Newphant/newphant-arm/assets/usd/Action_Graph.png

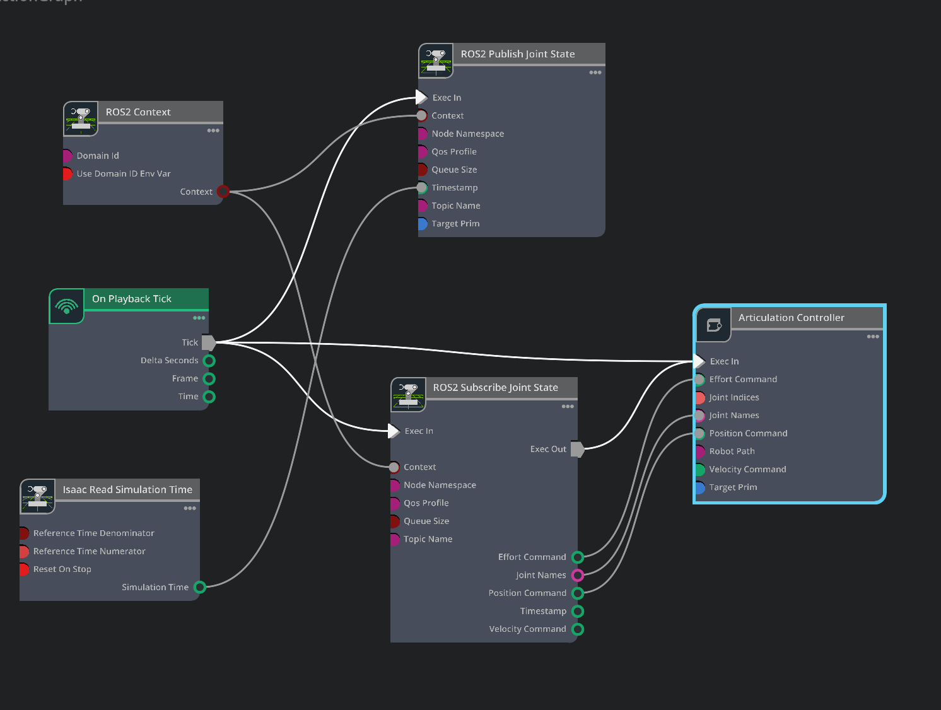
assets/usd/Action_Graph.png
