Newphant/newphant-arm/assets/urdf/main_arm/asset/rocker_right.stl

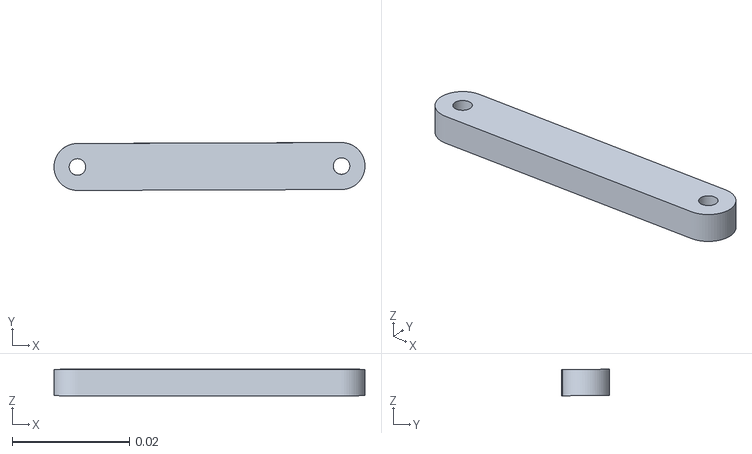
[picture p2: CAD file, 2026-11-11]
assets/urdf/main_arm/asset/rocker_right.stl
0.053 x 0.00817 x 0.00452
