Newphant/newphant-arm/cad/Gripper/adapter_head.step

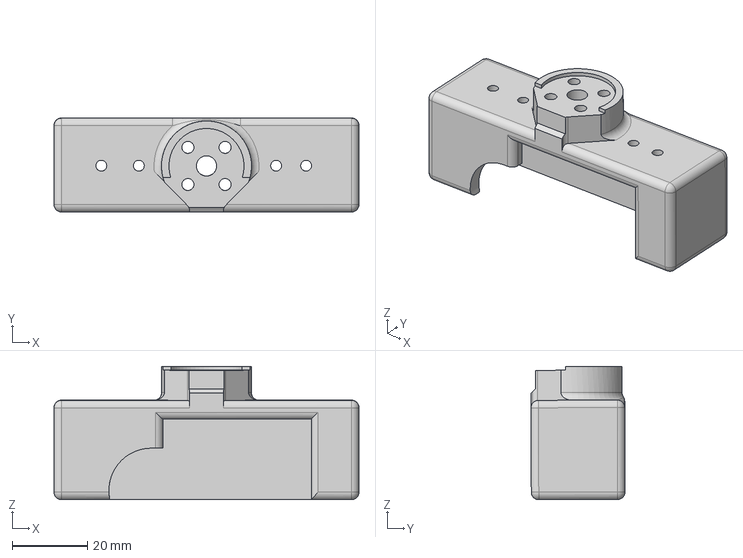
[picture p3: CAD file, 2026-11-11]
cad/Gripper/adapter_head.step
81.3 x 25.1 x 35.6 mm
