Newphant/newphant-arm/cad/ST3215_servo.step

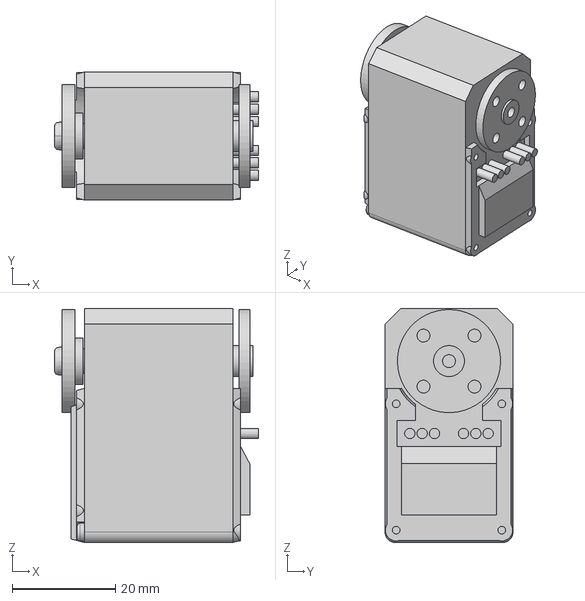
[picture p4: CAD file, 2026-11-11]
cad/ST3215_servo.step
39.6 x 24.8 x 45.4 mm
