Newphant/newphant-arm/assets/urdf/main_arm/asset/servo_ShA_should.stl

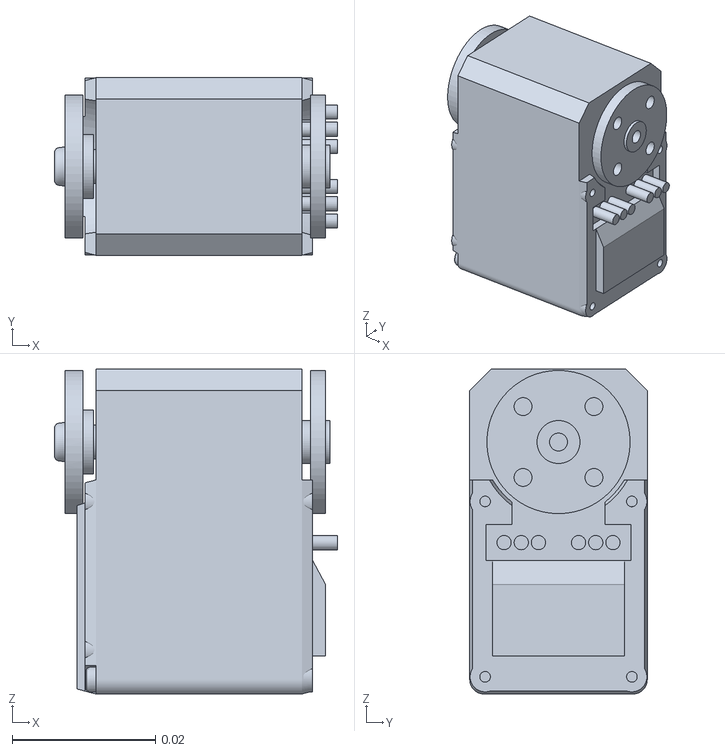
[picture p5: CAD file, 2026-11-11]
assets/urdf/main_arm/asset/servo_ShA_should.stl
0.0396 x 0.0248 x 0.0454
