Newphant/newphant-arm/cad/elbow_arm.step

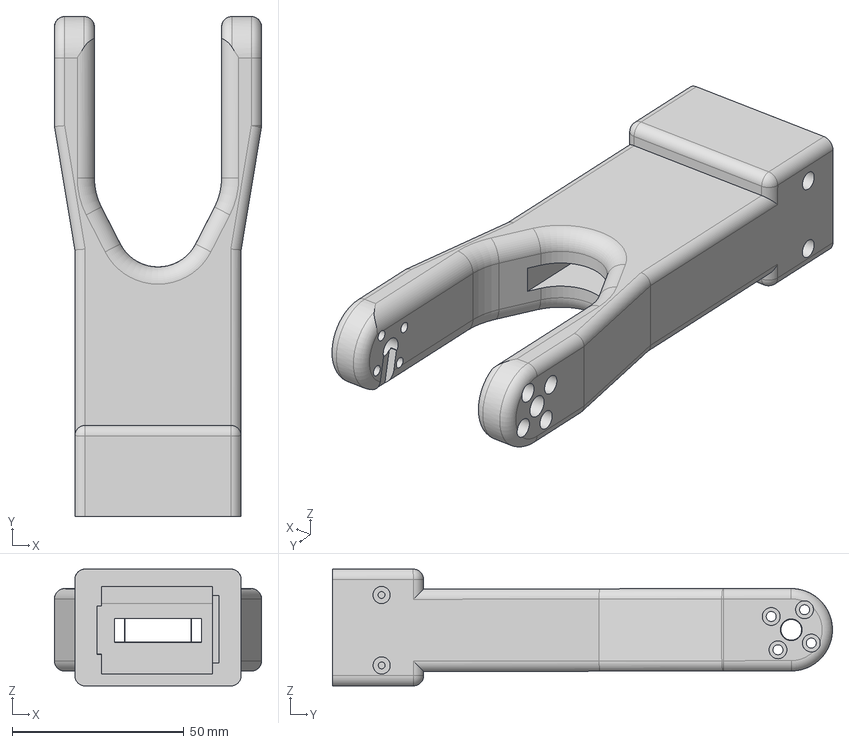
[picture p6: CAD file, 2026-11-11]
cad/elbow_arm.step
60.3 x 145.5 x 34.0 mm
