Newphant/newphant-arm/cad/Gripper/rocker_left.step

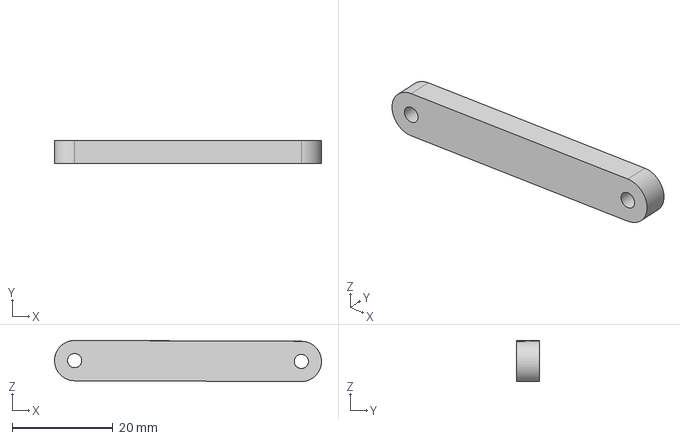
[picture p7: CAD file, 2026-11-11]
cad/Gripper/rocker_left.step
53.0 x 4.52 x 8.17 mm
