Newphant/newphant-arm/assets/urdf/main_arm/asset/coupler_right.stl

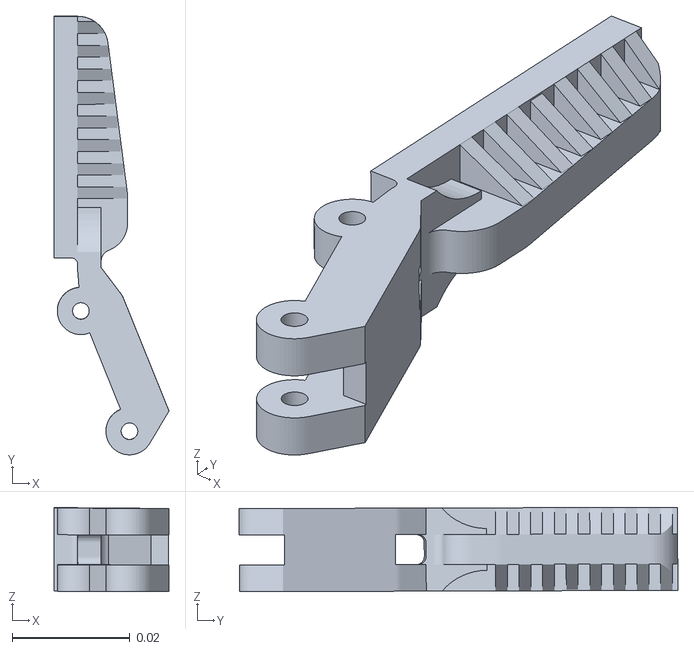
[picture p8: CAD file, 2026-11-11]
assets/urdf/main_arm/asset/coupler_right.stl
0.0195 x 0.0744 x 0.0143
