Newphant/newphant-arm/cad/ball_bearing.step

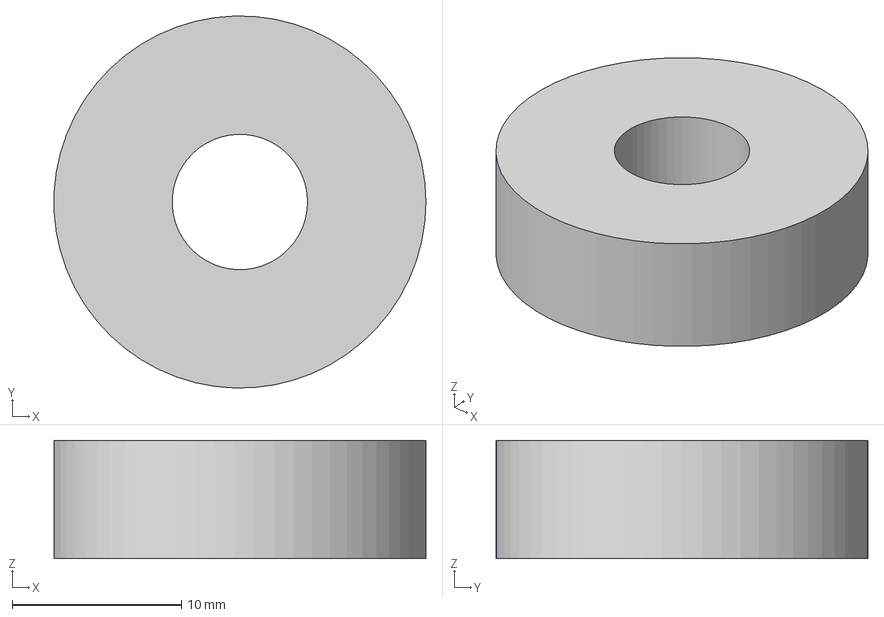
[picture p9: CAD file, 2026-11-11]
cad/ball_bearing.step
22.0 x 22.0 x 7.00 mm
