Newphant/newphant-arm/cad/Gripper/crank_right.step

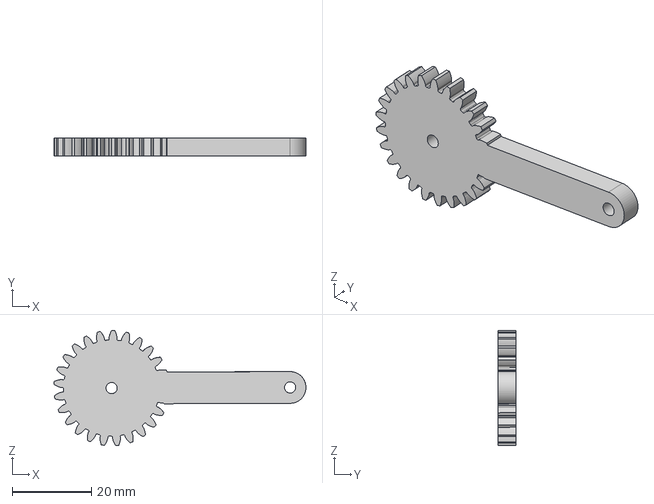
[picture p10: CAD file, 2026-11-11]
cad/Gripper/crank_right.step
63.5 x 4.59 x 29.1 mm
