Newphant/newphant-arm/assets/urdf/main_arm/asset/base_plate.stl

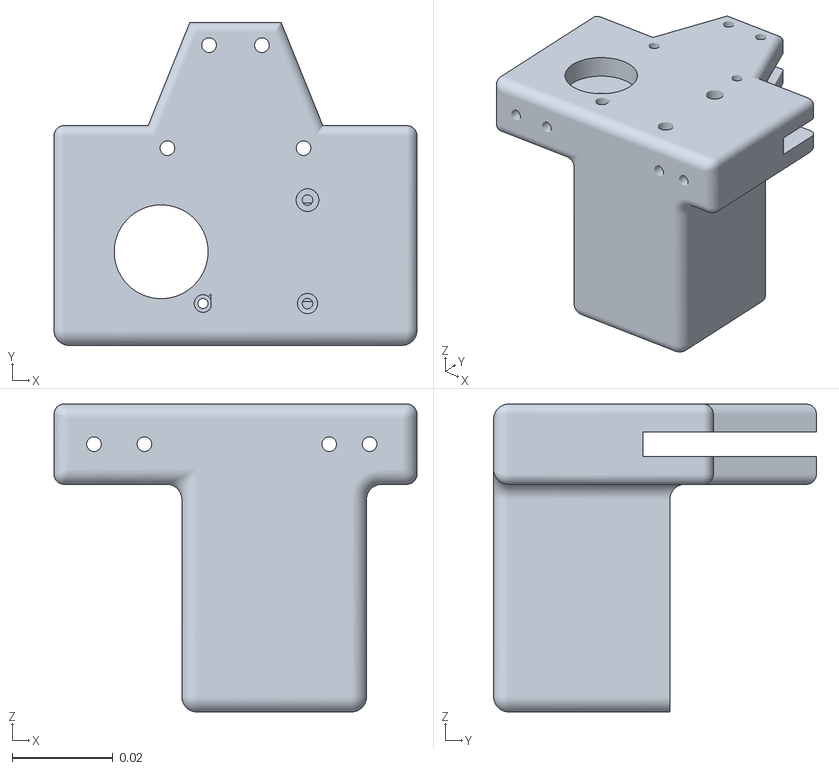
[picture p11: CAD file, 2026-11-11]
assets/urdf/main_arm/asset/base_plate.stl
0.0719 x 0.064 x 0.061
