Newphant/newphant-arm/cad/Gripper/servotip.step

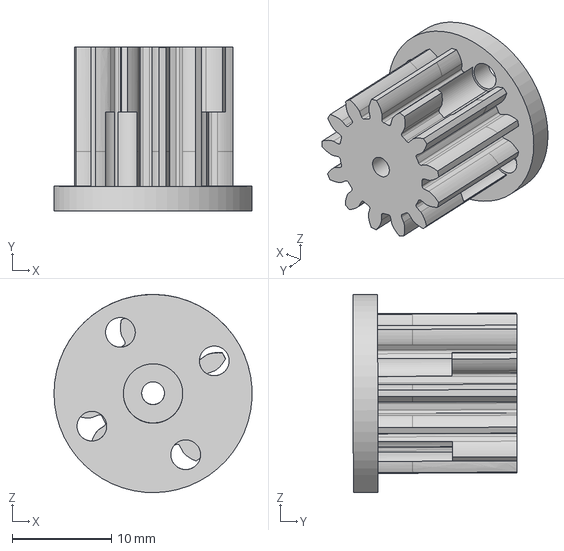
[picture p12: CAD file, 2026-11-11]
cad/Gripper/servotip.step
20.0 x 16.6 x 20.0 mm
