Newphant/newphant-arm/cad/wrist.step

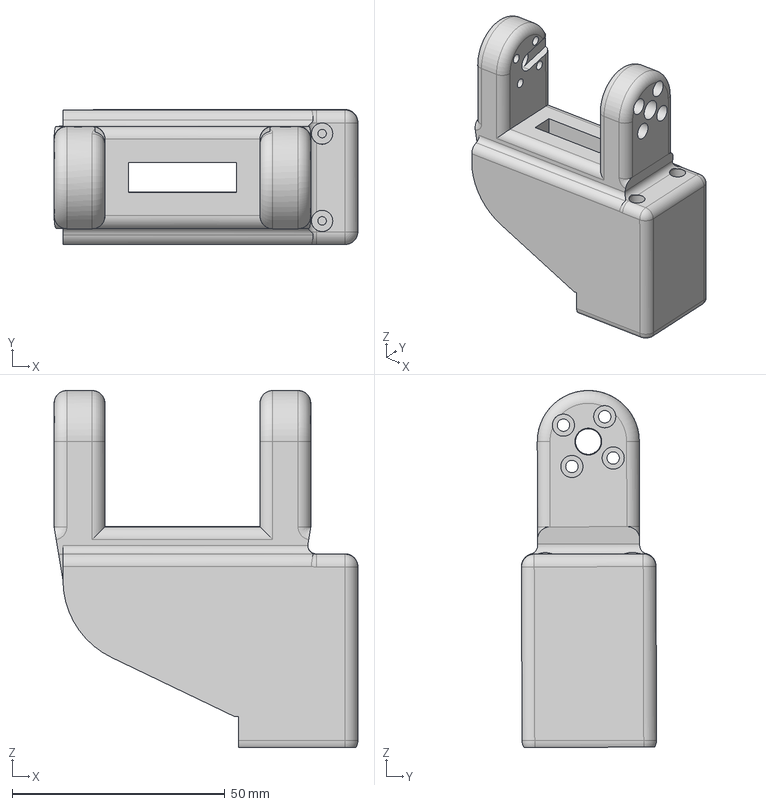
[picture p13: CAD file, 2026-11-11]
cad/wrist.step
71.4 x 31.7 x 83.8 mm
