Newphant/newphant-arm/cad/shoulder_arm.step

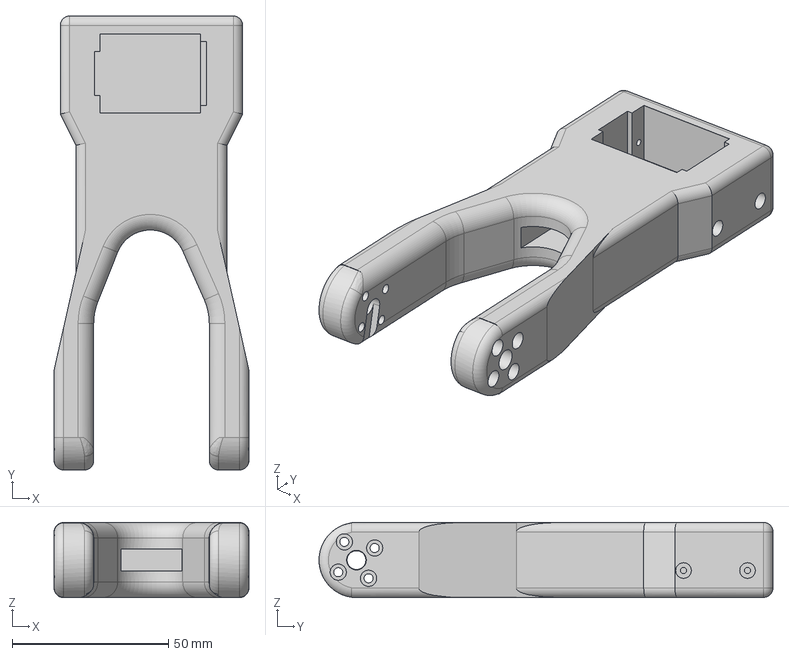
[picture p14: CAD file, 2026-11-11]
cad/shoulder_arm.step
62.4 x 145.4 x 24.1 mm
