Newphant/newphant-arm/assets/urdf/main_arm/asset/adapter_head.stl

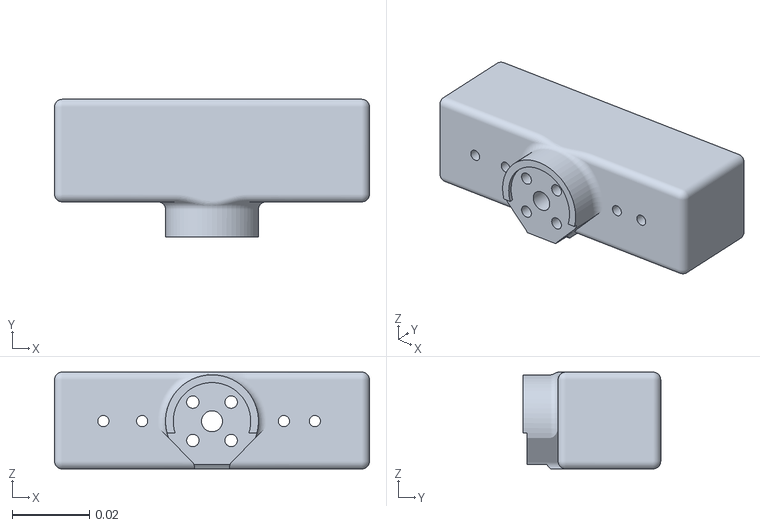
[picture p15: CAD file, 2026-11-11]
assets/urdf/main_arm/asset/adapter_head.stl
0.0813 x 0.0355 x 0.025
