Newphant/newphant-arm/cad/shoulder.step

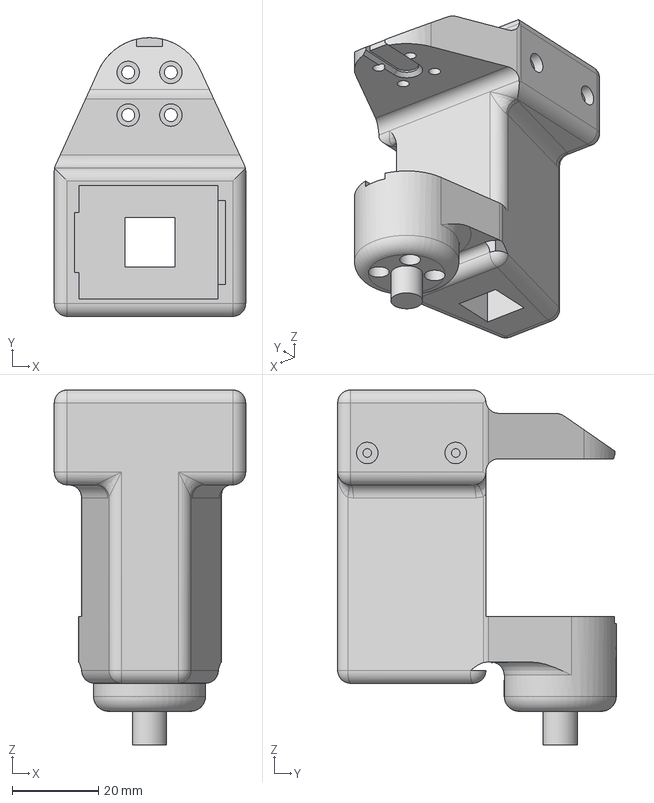
[picture p16: CAD file, 2026-11-11]
cad/shoulder.step
44.4 x 64.6 x 82.3 mm
