Newphant/newphant-arm/cad/base_link.step

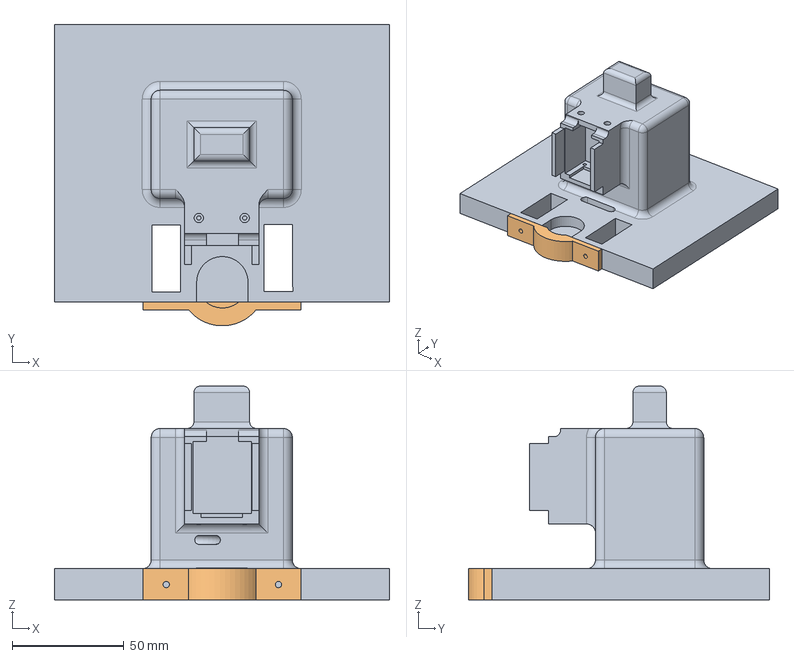
[picture p17: CAD file, 2026-11-11]
cad/base_link.step
150.0 x 135.0 x 95.8 mm
