Newphant/newphant-arm/cad/Gripper/coupler_left.step

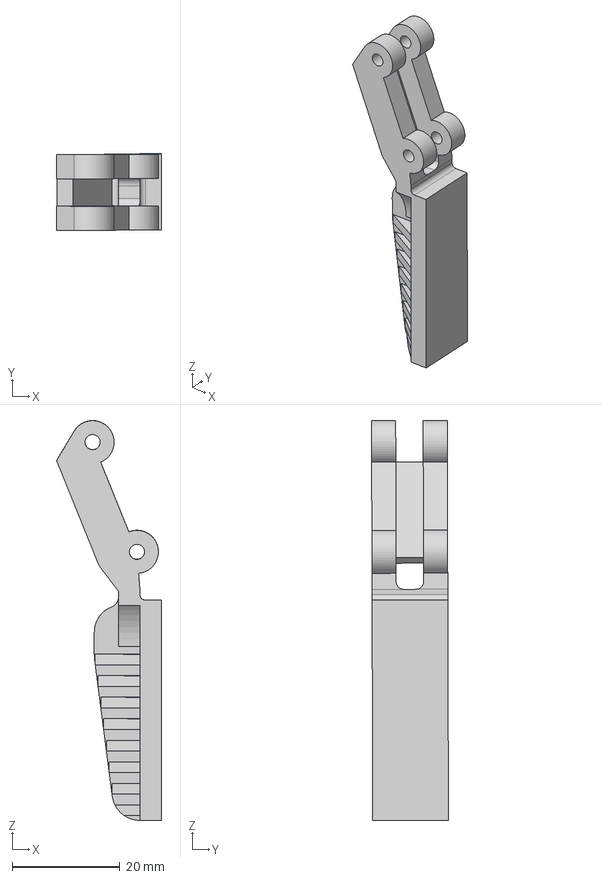
[picture p18: CAD file, 2026-11-11]
cad/Gripper/coupler_left.step
19.5 x 14.3 x 74.4 mm
