Newphant/newphant-arm/assets/urdf/main_arm/asset/elbow_arm.stl

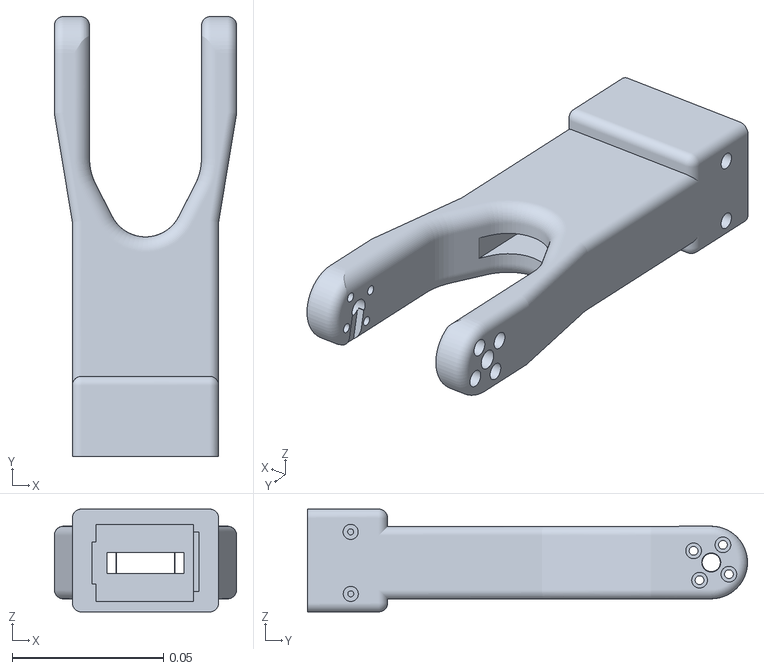
[picture p19: CAD file, 2026-11-11]
assets/urdf/main_arm/asset/elbow_arm.stl
0.0603 x 0.146 x 0.034
