Newphant/newphant-arm/assets/urdf/main_arm/asset/base_link.stl

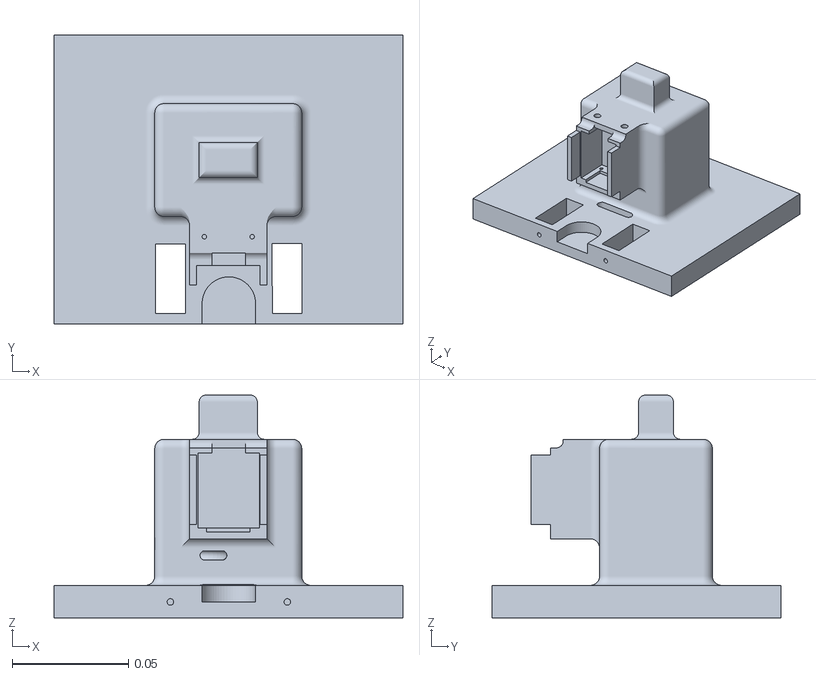
[picture p20: CAD file, 2026-11-11]
assets/urdf/main_arm/asset/base_link.stl
0.15 x 0.124 x 0.0958
