Newphant/newphant-arm/cad/Gripper/base_plate.step

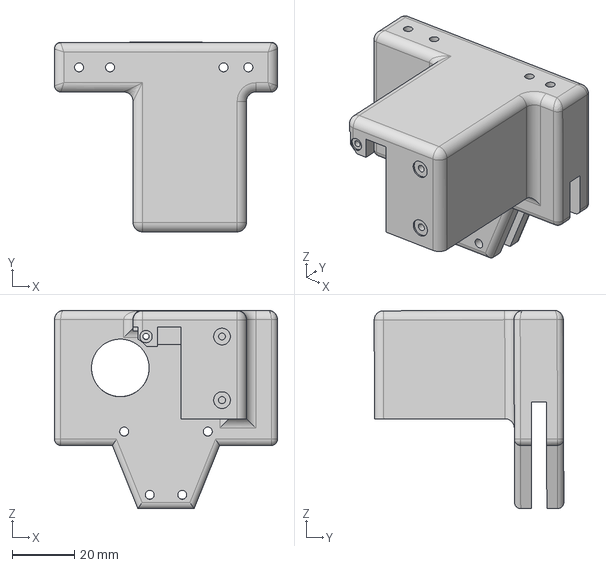
[picture p21: CAD file, 2026-11-11]
cad/Gripper/base_plate.step
71.9 x 61.2 x 64.0 mm
