Newphant/newphant-arm/assets/urdf/main_arm/asset/should.stl

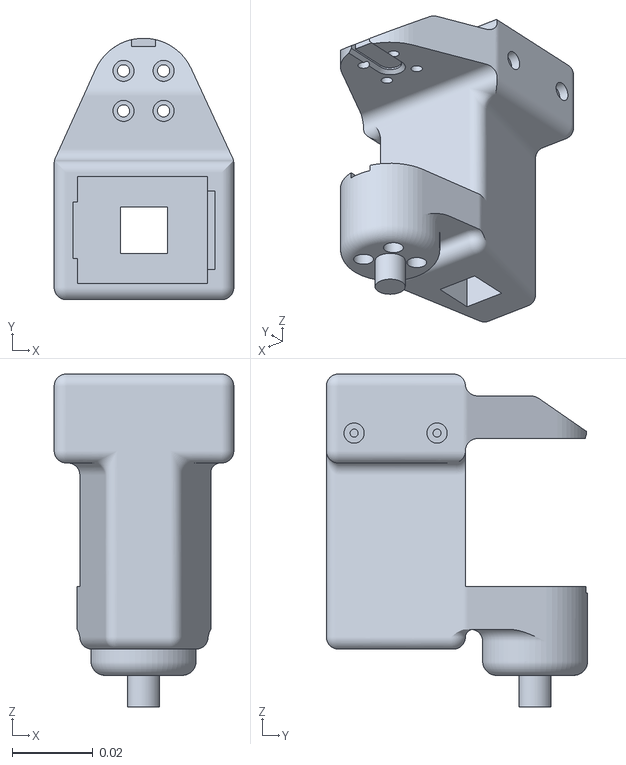
[picture p22: CAD file, 2026-11-11]
assets/urdf/main_arm/asset/should.stl
0.0444 x 0.0646 x 0.0823
