Newphant/newphant-arm/assets/urdf/main_arm/asset/crank_left.stl

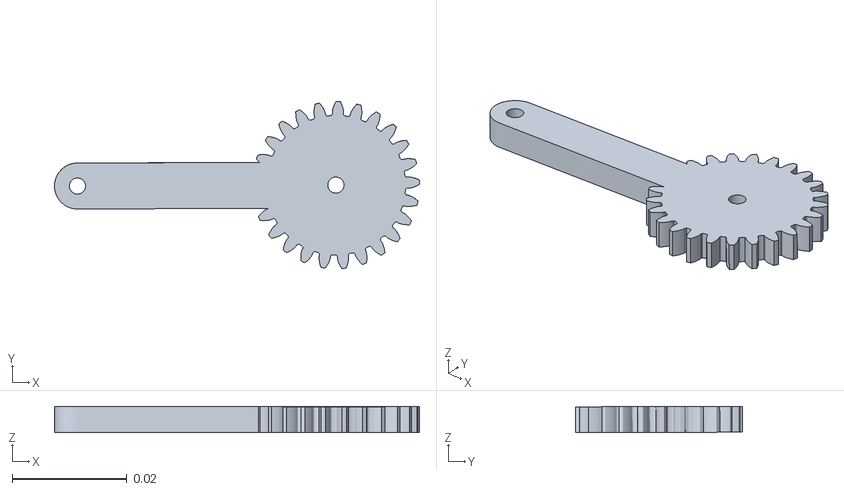
[picture p23: CAD file, 2026-11-11]
assets/urdf/main_arm/asset/crank_left.stl
0.0636 x 0.0291 x 0.00459
