Newphant/newphant-arm/assets/urdf/main_arm/asset/wrist.stl

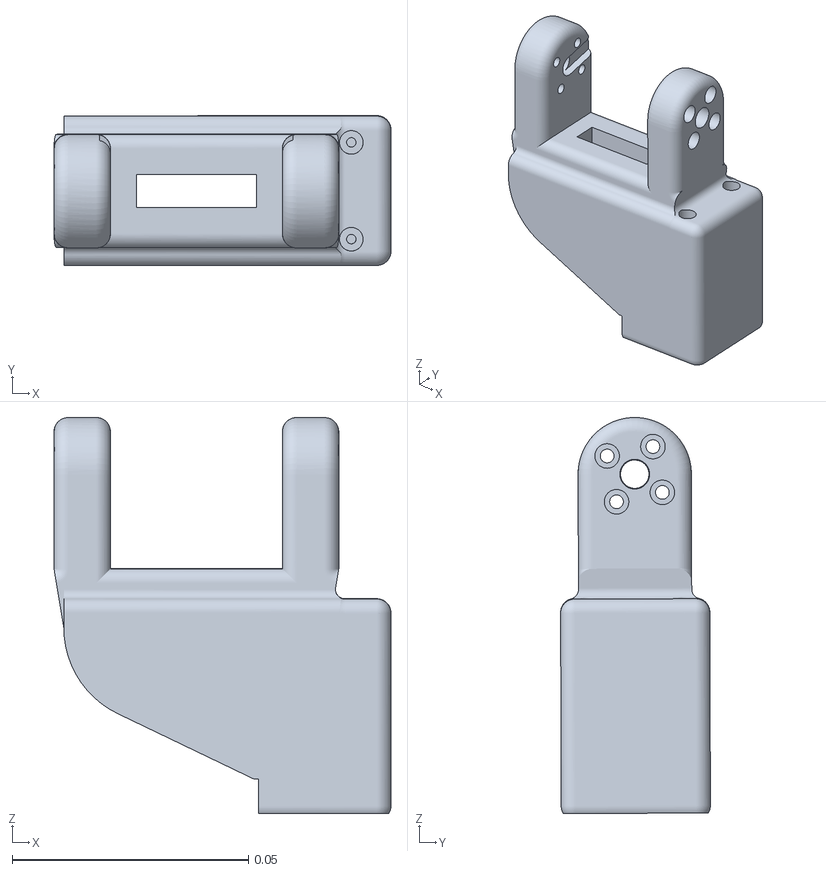
[picture p24: CAD file, 2026-11-11]
assets/urdf/main_arm/asset/wrist.stl
0.0714 x 0.0317 x 0.0838
