Newphant/newphant-arm/assets/urdf/main_arm/asset/shoulder_arm.stl

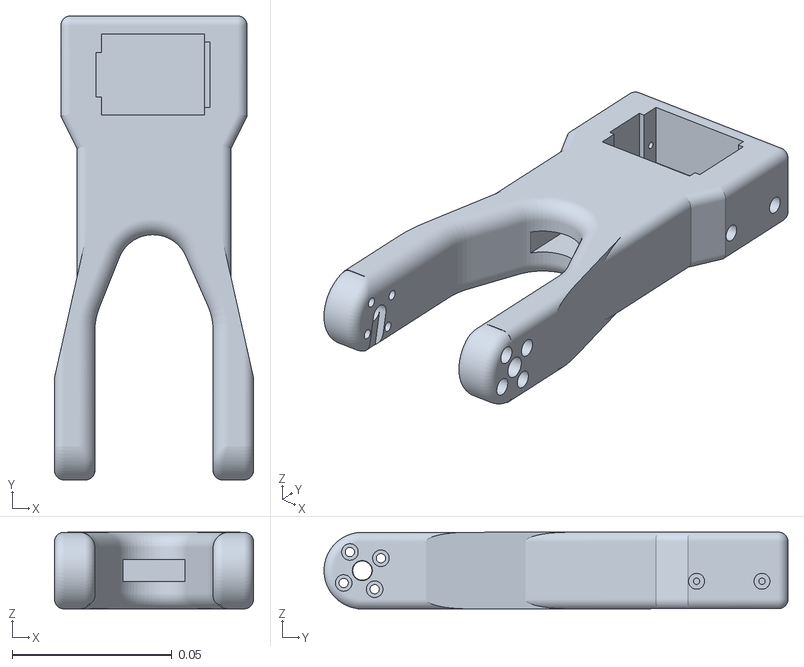
[picture p25: CAD file, 2026-11-11]
assets/urdf/main_arm/asset/shoulder_arm.stl
0.0624 x 0.145 x 0.0241
