Newphant/newphant-arm/assets/urdf/main_arm/asset/servotip.stl

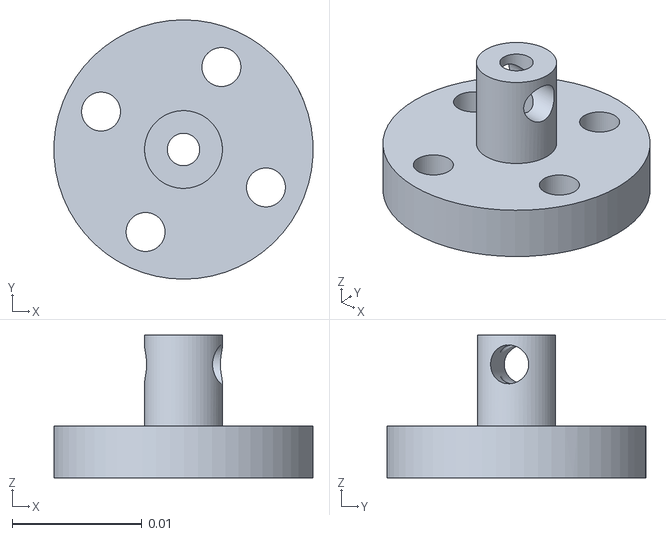
[picture p26: CAD file, 2026-11-11]
assets/urdf/main_arm/asset/servotip.stl
0.02 x 0.02 x 0.011
