Newphant/newphant-arm/assets/urdf/main_arm/asset/servotip_1.stl

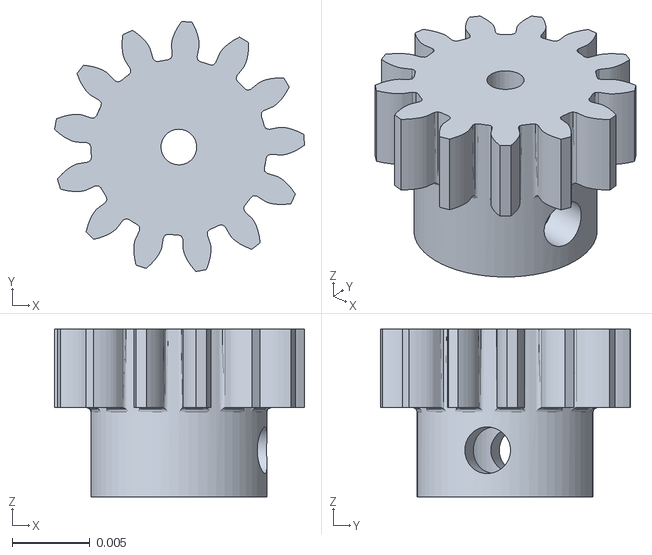
[picture p27: CAD file, 2026-11-11]
assets/urdf/main_arm/asset/servotip_1.stl
0.0161 x 0.0161 x 0.0108
