Newphant/newphant-arm/(list of files, cad)

Other CAD files:
cad/Gripper/servotip_new.step
cad/Gripper/crank_left.step
cad/Gripper/coupler_right.step
assets/urdf/main_arm/asset/coupler_left.stl
assets/urdf/main_arm/asset/crank_right.stl
