Newphant/newphant-arm/(commit log)

2026-11-11 Initial import: source only
    [ST3215_servo.step, adapter_head.step, adapter_head.stl, ball_bearing.step, base_link.step, base_link.stl, base_plate.step, base_plate.stl]
2026-11-11 Switch license to MIT
